Naman-K06/RIS_2.4Ghz/Matlab/Figures/WP_Figure4_RSSI_Heatmap.pdf

Wireless Performance Comparison

No RIS | 2x2 RIS | 5x5 RIS | 9x9 RIS | 16x16 RIS

Valu

e (Units v

ary)

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
Avg RSSI (Relative)
Avg SNR (dB)
