Naman-K06/RIS_2.4Ghz/Matlab/Figures/RIS_Array.png

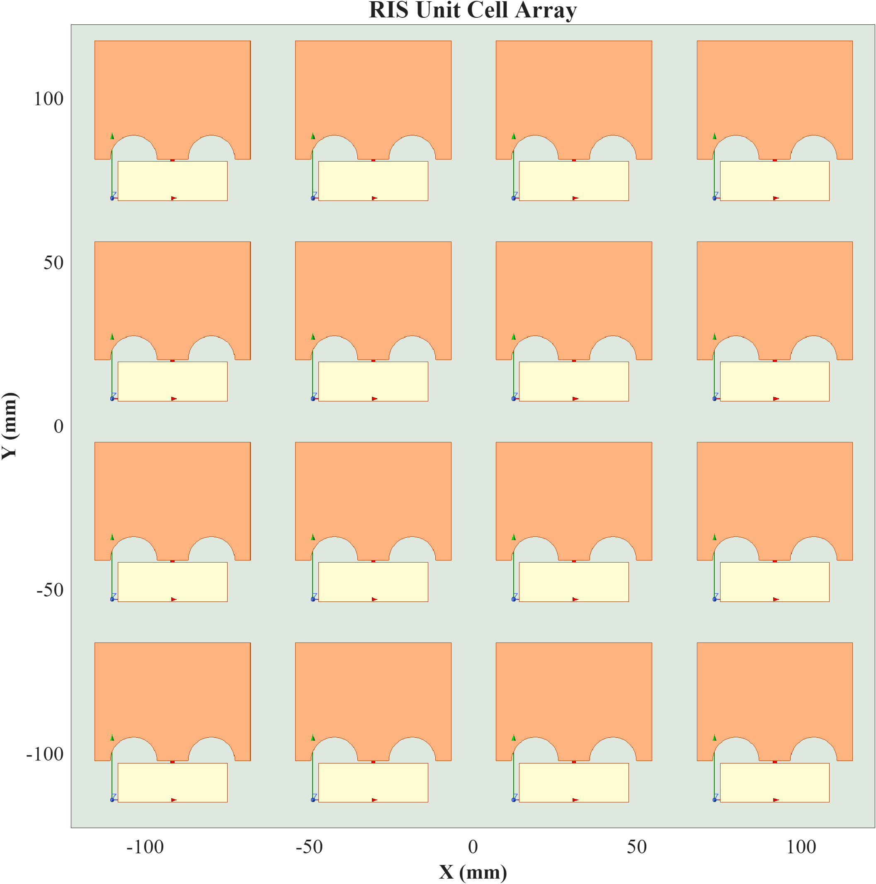
Matlab/Figures/RIS_Array.png
