Naman-K06/RIS_2.4Ghz/Matlab/Figures/SC_Figure1_RSSI.png

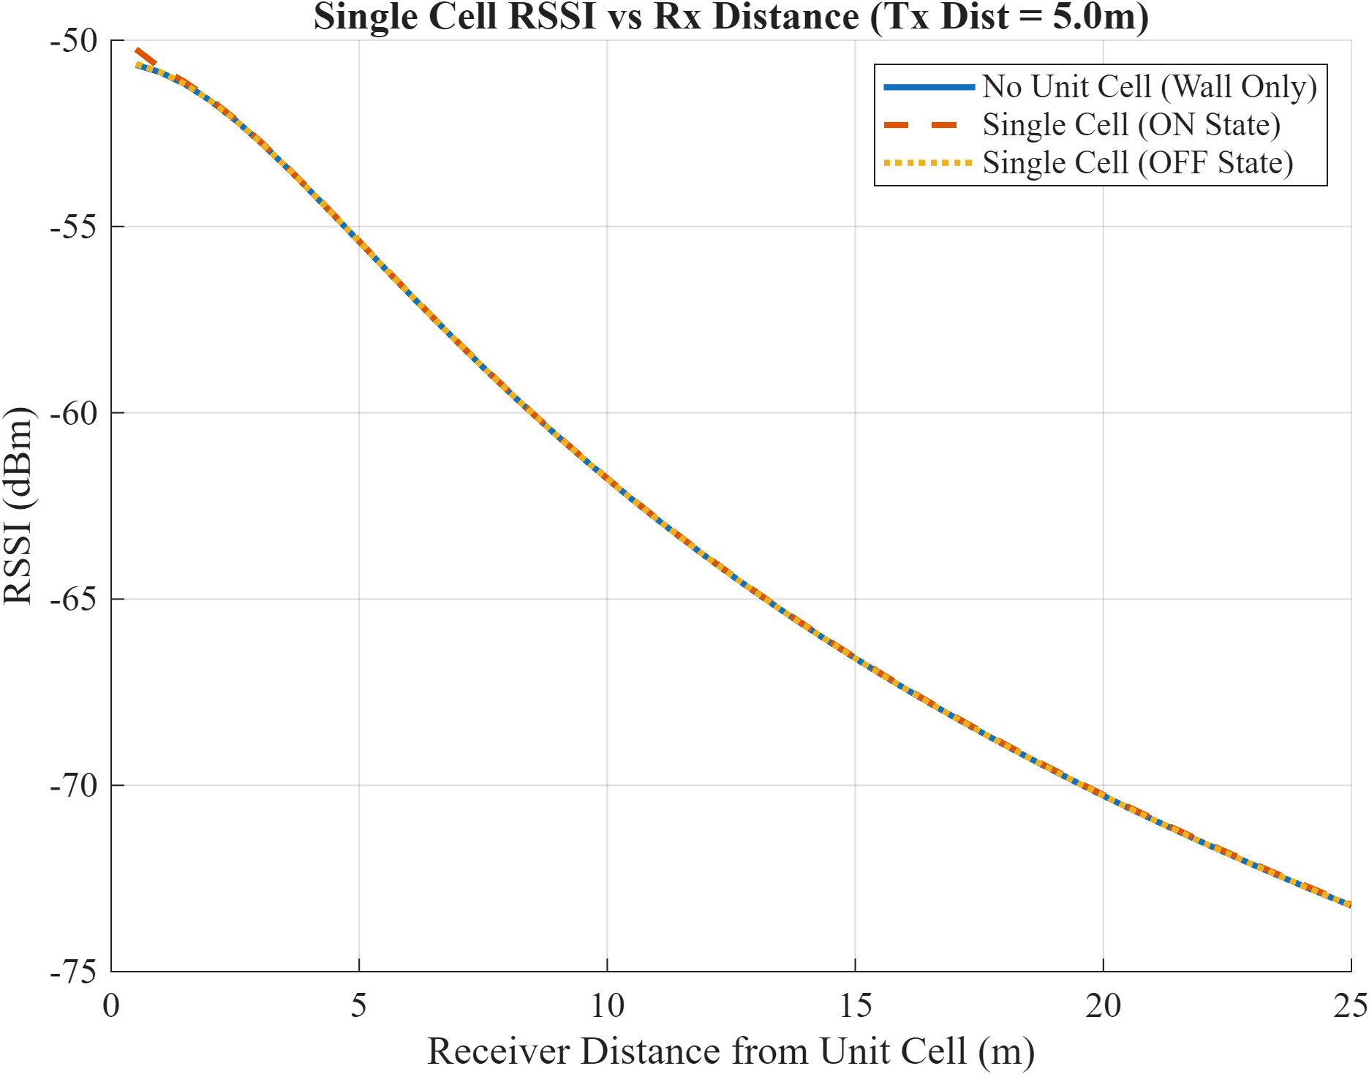
Matlab/Figures/SC_Figure1_RSSI.png
