Naman-K06/RIS_2.4Ghz/Matlab/Figures/SC_Figure2_SNR.png

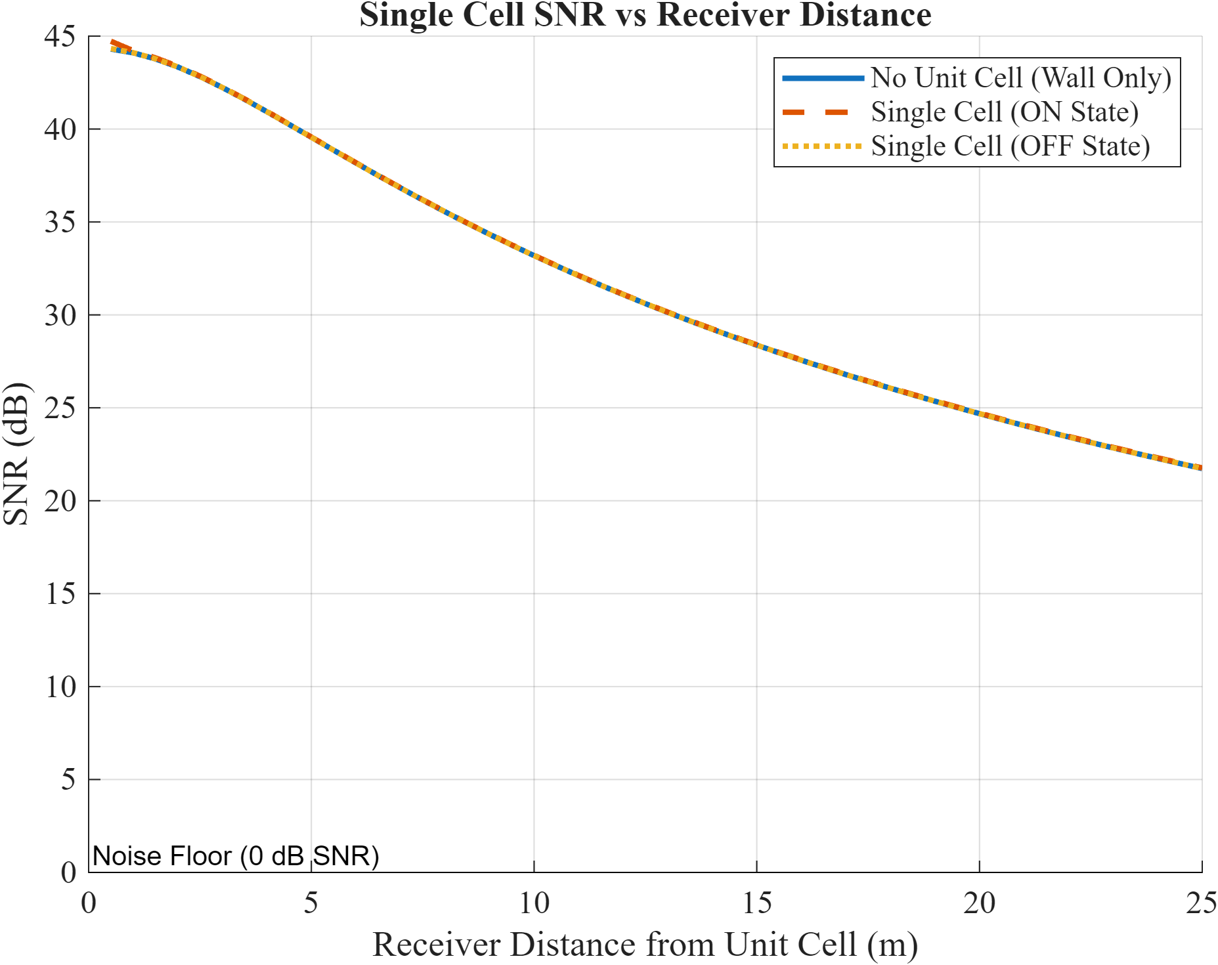
Matlab/Figures/SC_Figure2_SNR.png
