Naman-K06/RIS_2.4Ghz/Matlab/Figures/SC_Figure3_PathLoss.png

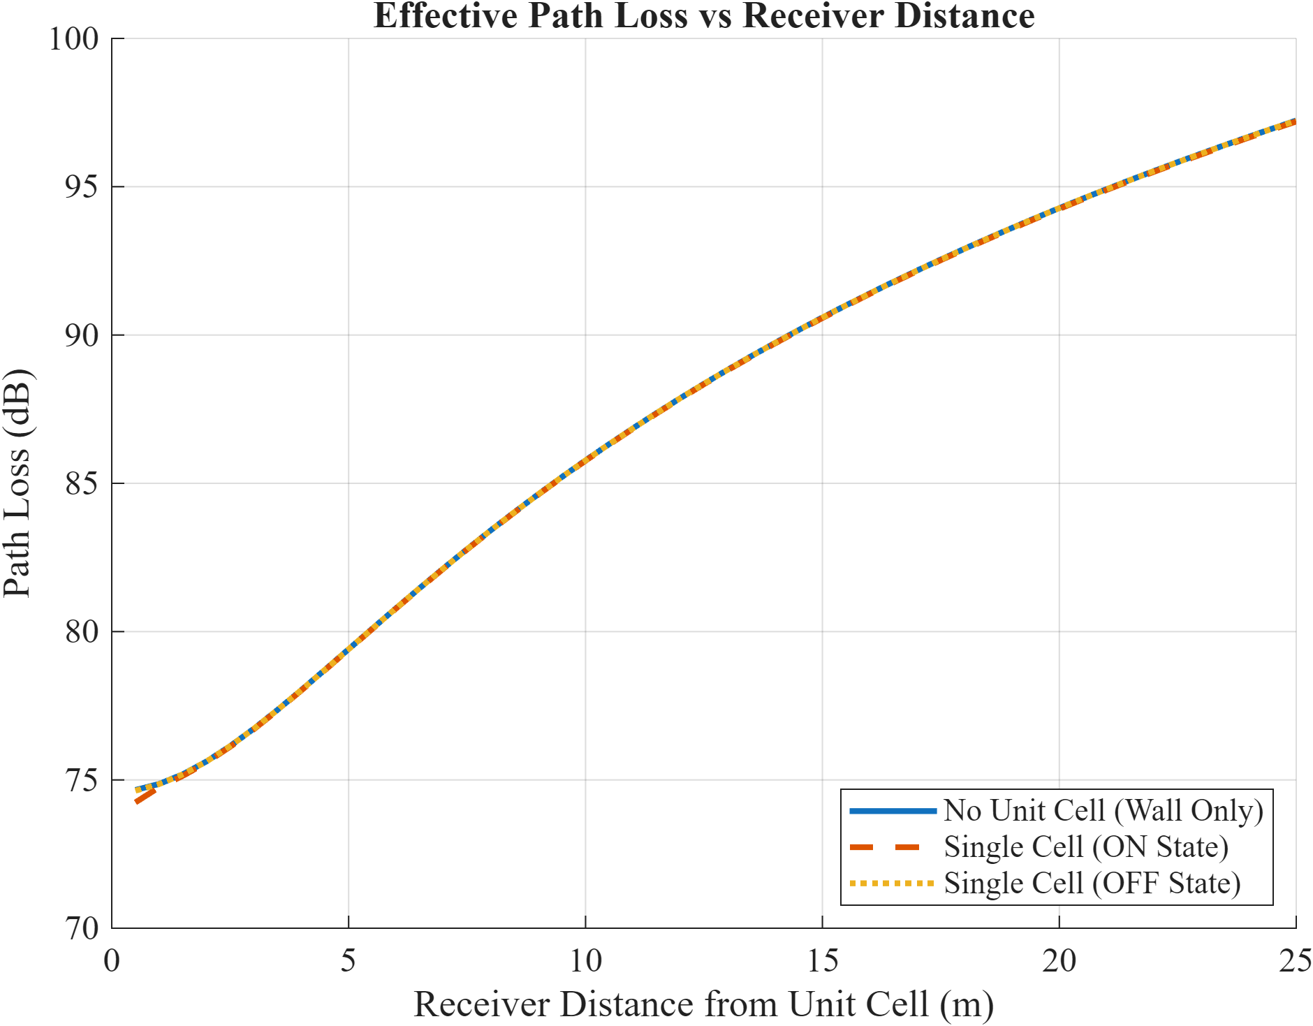
Matlab/Figures/SC_Figure3_PathLoss.png
