Naman-K06/RIS_2.4Ghz/Matlab/Figures/WP_Figure1_RSSI.png

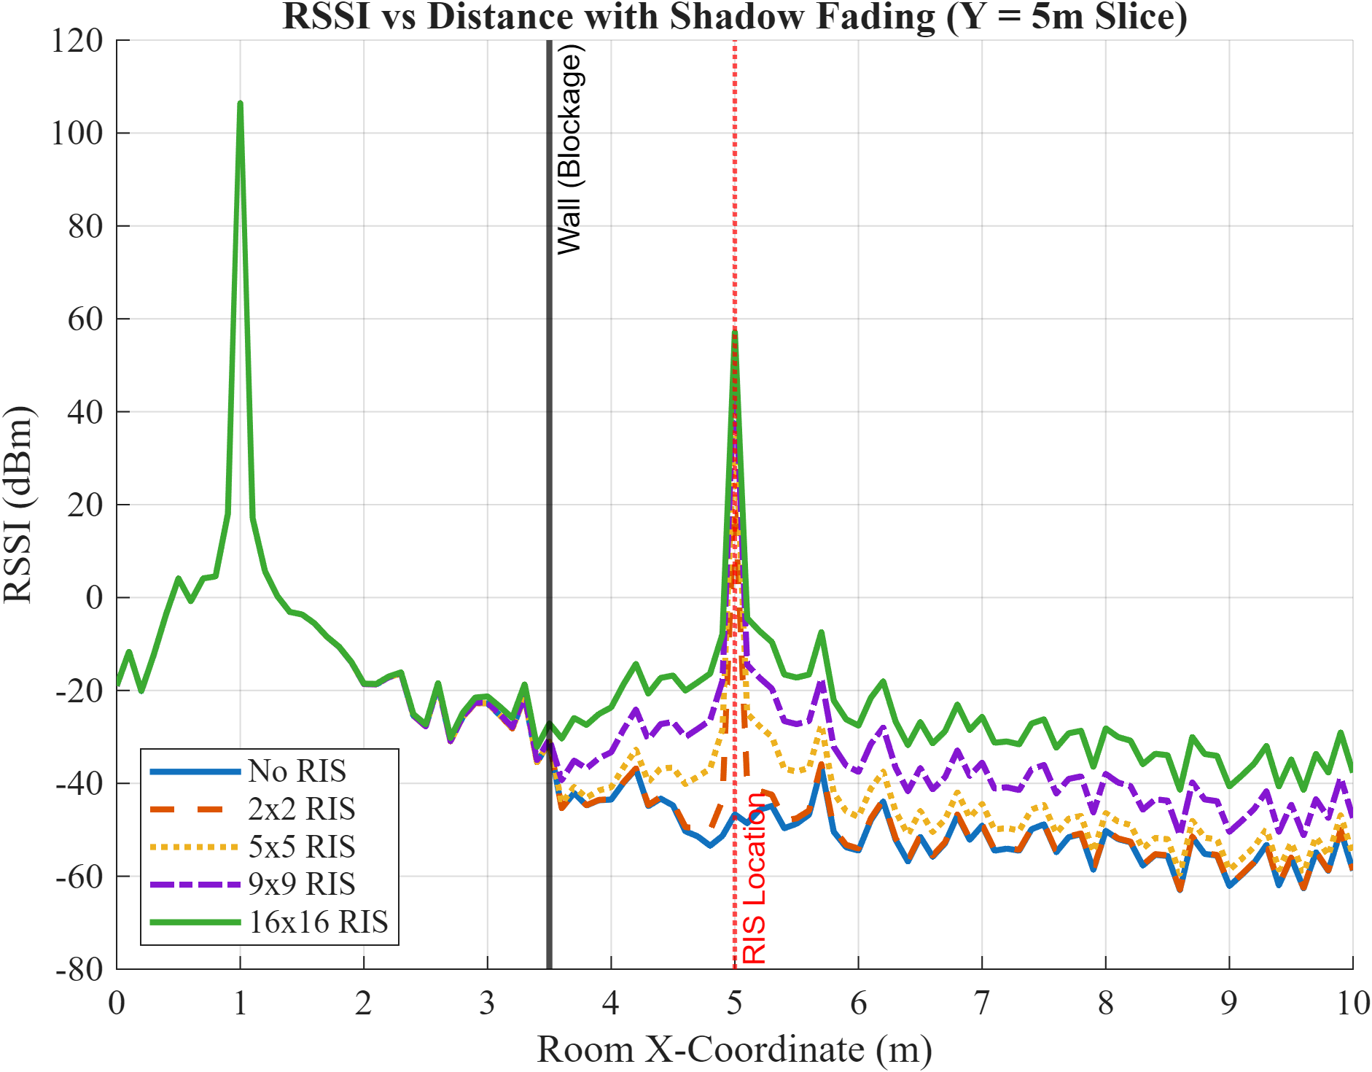
Matlab/Figures/WP_Figure1_RSSI.png
