Naman-K06/RIS_2.4Ghz/Matlab/Figures/WP_Figure2_SNR.png

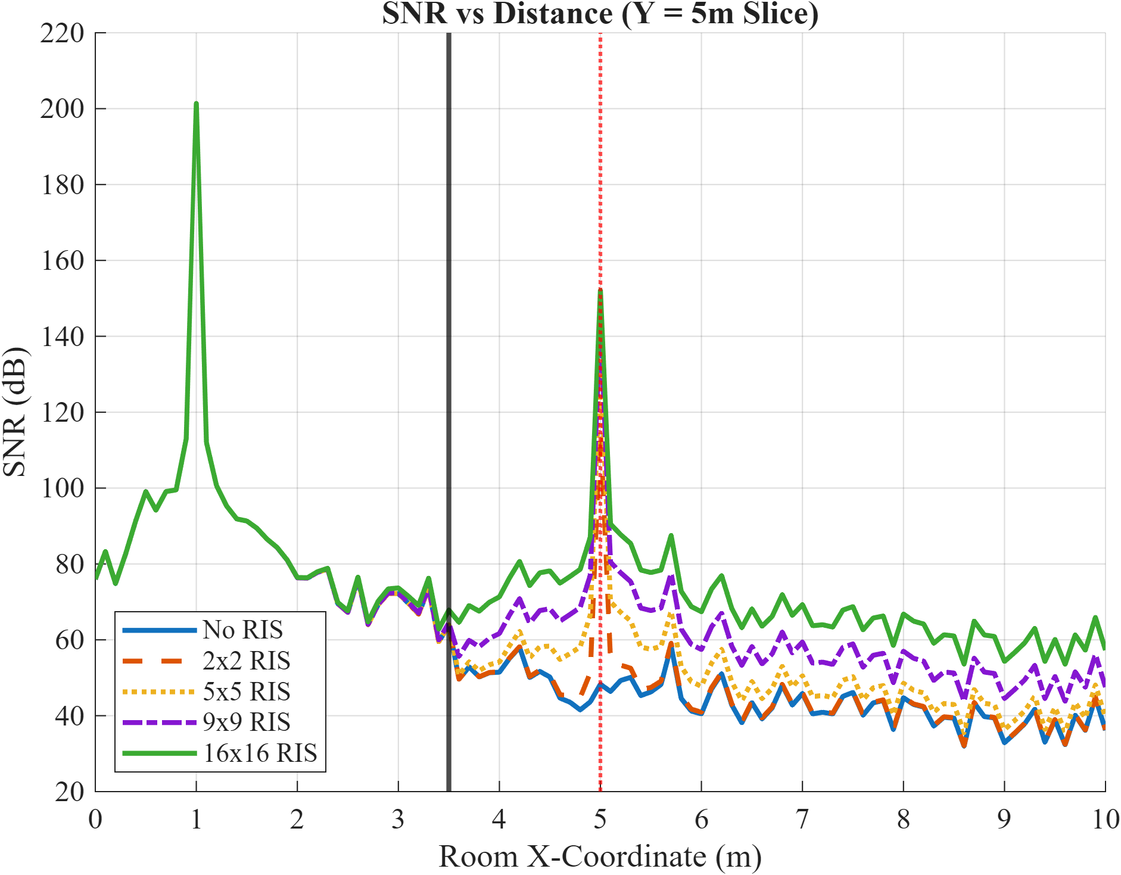
Matlab/Figures/WP_Figure2_SNR.png
