Naman-K06/RIS_2.4Ghz/Matlab/Figures/WP_Figure3_PathLoss.png

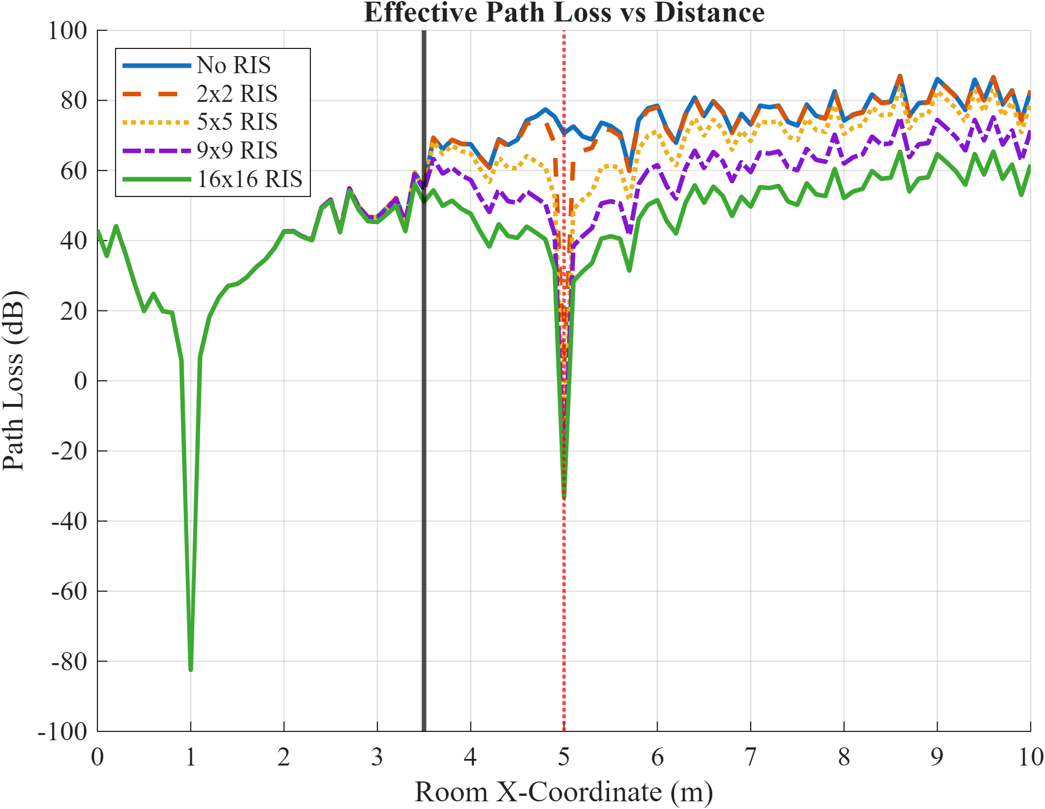
Matlab/Figures/WP_Figure3_PathLoss.png
