Naman-K06/RIS_2.4Ghz/Matlab/Figures/WP_Figure4_RSSI_Heatmap.png

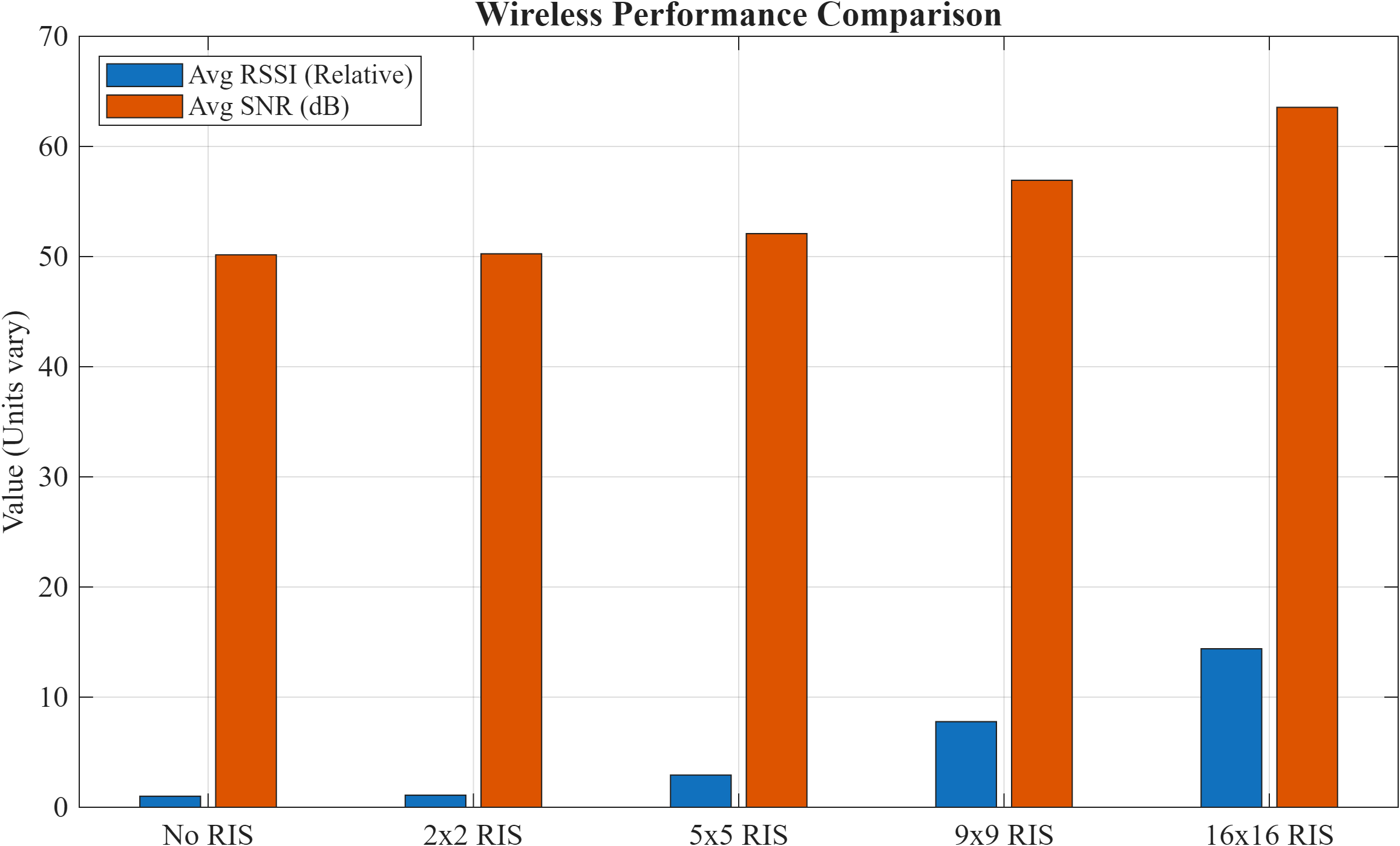
Matlab/Figures/WP_Figure4_RSSI_Heatmap.png
