Naman-K06/RIS_2.4Ghz/Matlab/Unit Cell/UnitCell.png

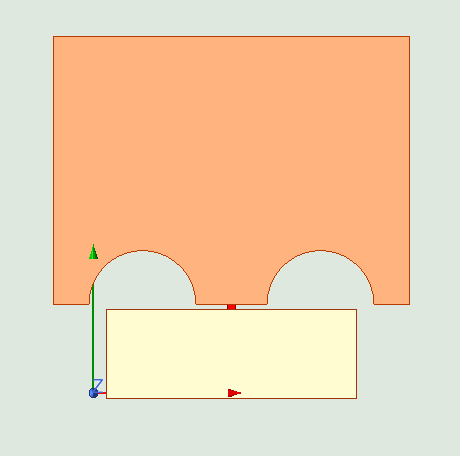
Matlab/Unit Cell/UnitCell.png
