Naman-K06/RIS_2.4Ghz/Matlab/Results/Performance_Table.csv

Configuration | Average_RSSI_dBm | Maximum_RSSI_dBm | Average_SNR_dB | Average_PathLoss_dB | RIS_Gain_dBi
No RIS | -44.8068115417836 | 106.429171015718 | 50.1580756958048 | 68.8068115417836 | 0
2x2 RIS | -44.71292778017 | 106.429171015718 | 50.2519594574183 | 68.71292778017 | 8.21926683868648
5x5 RIS | -42.880865383174 | 106.429171015718 | 52.0840218544144 | 66.8808653831739 | 24.136867185568
9x9 RIS | -38.036544857148 | 106.429171015718 | 56.9283423804404 | 62.036544857148 | 34.3477673897002
16x16 RIS | -31.4138692363174 | 106.429171015718 | 63.5510180012709 | 55.4138692363175 | 44.3428663183642
