Naman-K06/RIS_2.4Ghz/Matlab/Results/SingleCell_Table.csv

Configuration | Average_RSSI_dBm | Maximum_RSSI_dBm | Average_SNR_dB | Cell_Reflection_Gain_dBi
No Unit Cell (Wall Only) | -63.3784717167683 | -50.6612759926142 | 31.58641552082 | 0
Single Cell (ON State) | -63.347731972075 | -50.2411887809816 | 31.6171552655133 | 3.815
Single Cell (OFF State) | -63.376726748319 | -50.6366891254302 | 31.5881604892693 | -8.7108
