Naman-K06/RIS_2.4Ghz/RIS Results/2x2 Array/Screenshot 2026-08-10 184113.png

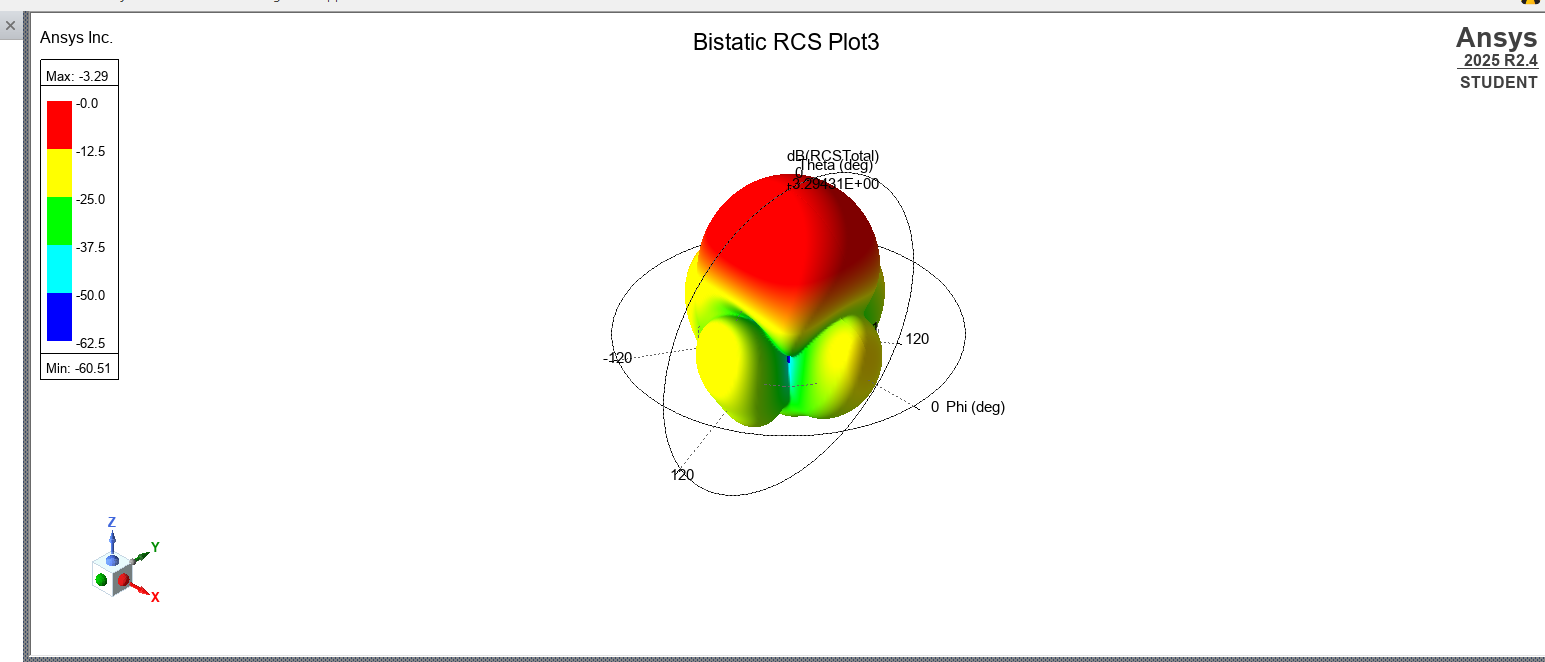
RIS Results/2x2 Array/Screenshot 2026-08-10 184113.png
