Naman-K06/RIS_2.4Ghz/RIS Results/4x4 Array/Screenshot 2026-08-18 163440.png

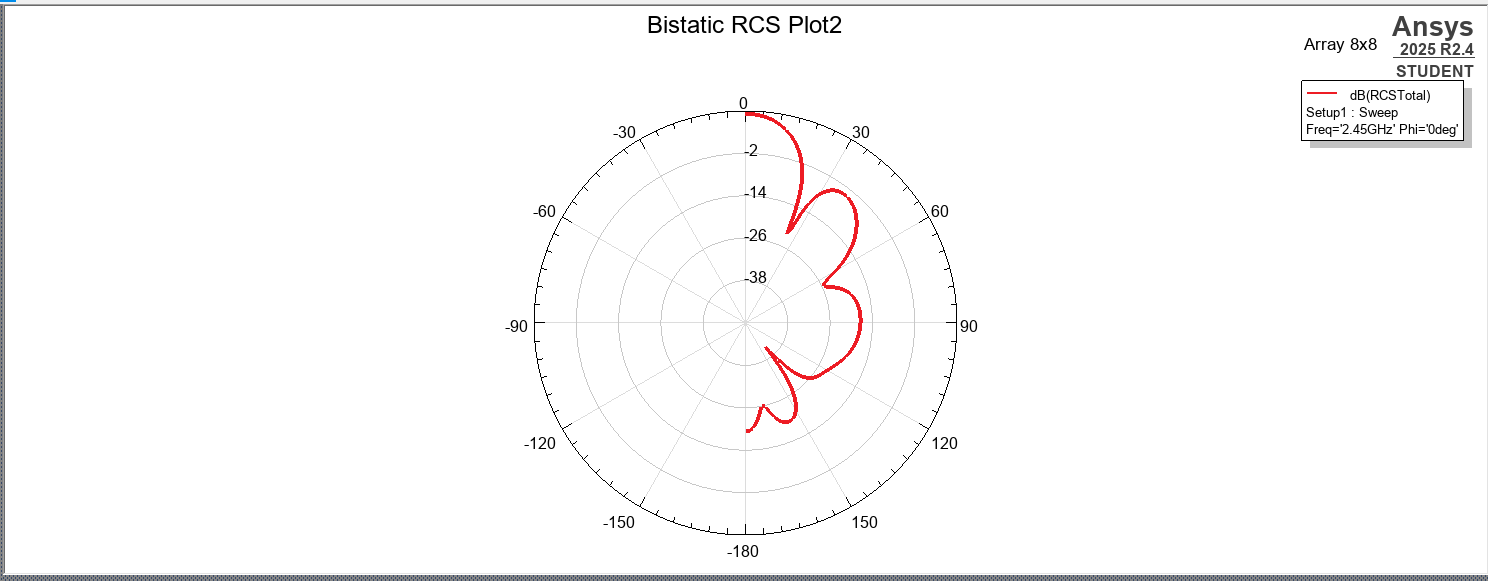
RIS Results/4x4 Array/Screenshot 2026-08-18 163440.png
