Naman-K06/RIS_2.4Ghz/RIS Results/Bias Control Circuit/Screenshot 2026-08-30 230548.png

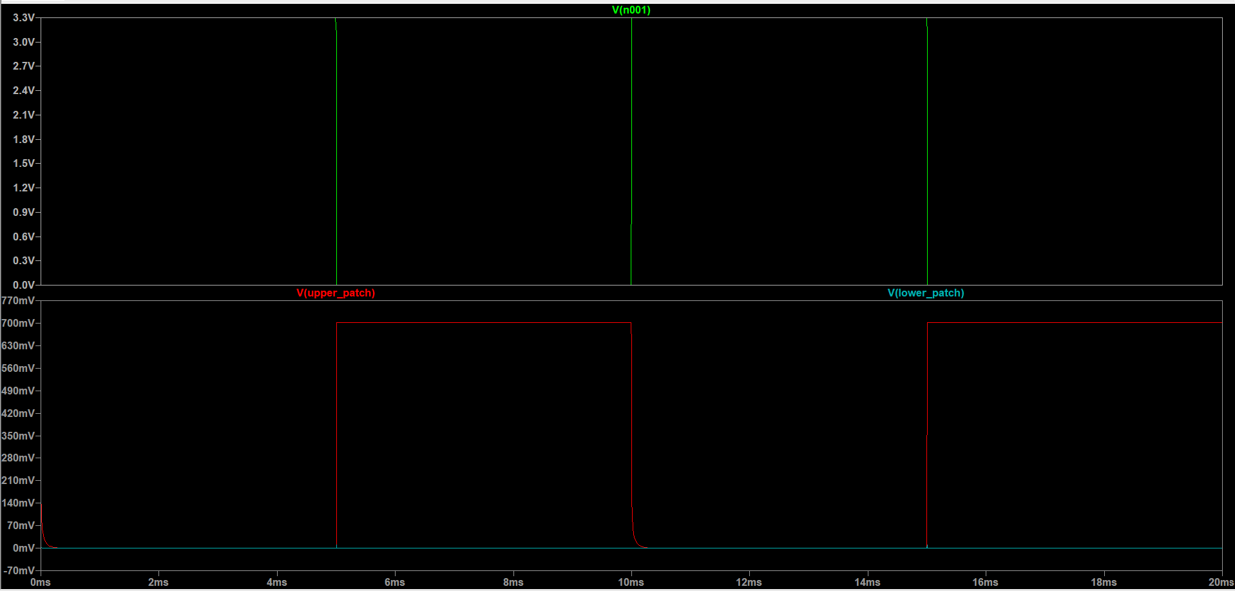
RIS Results/Bias Control Circuit/Screenshot 2026-08-30 230548.png
