Naman-K06/RIS_2.4Ghz/RIS Results/Bias Control Circuit/Screenshot 2026-09-07 162614.png

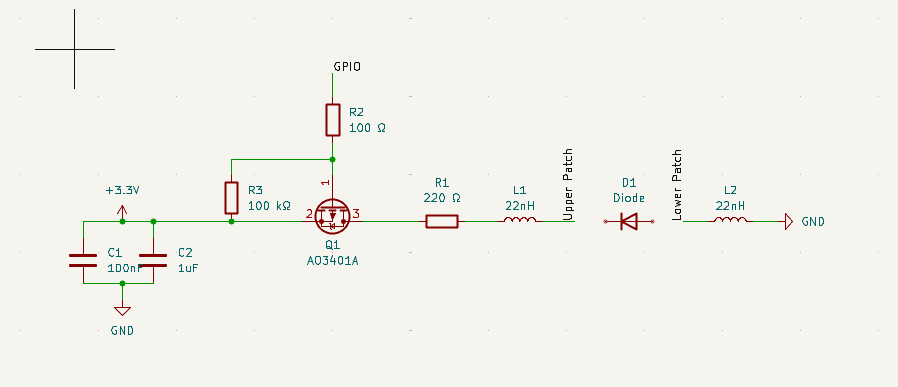
RIS Results/Bias Control Circuit/Screenshot 2026-09-07 162614.png
