Naman-K06/RIS_2.4Ghz/RIS Results/Unit Cell/Bias Lines/Screenshot 2026-08-21 224558.png

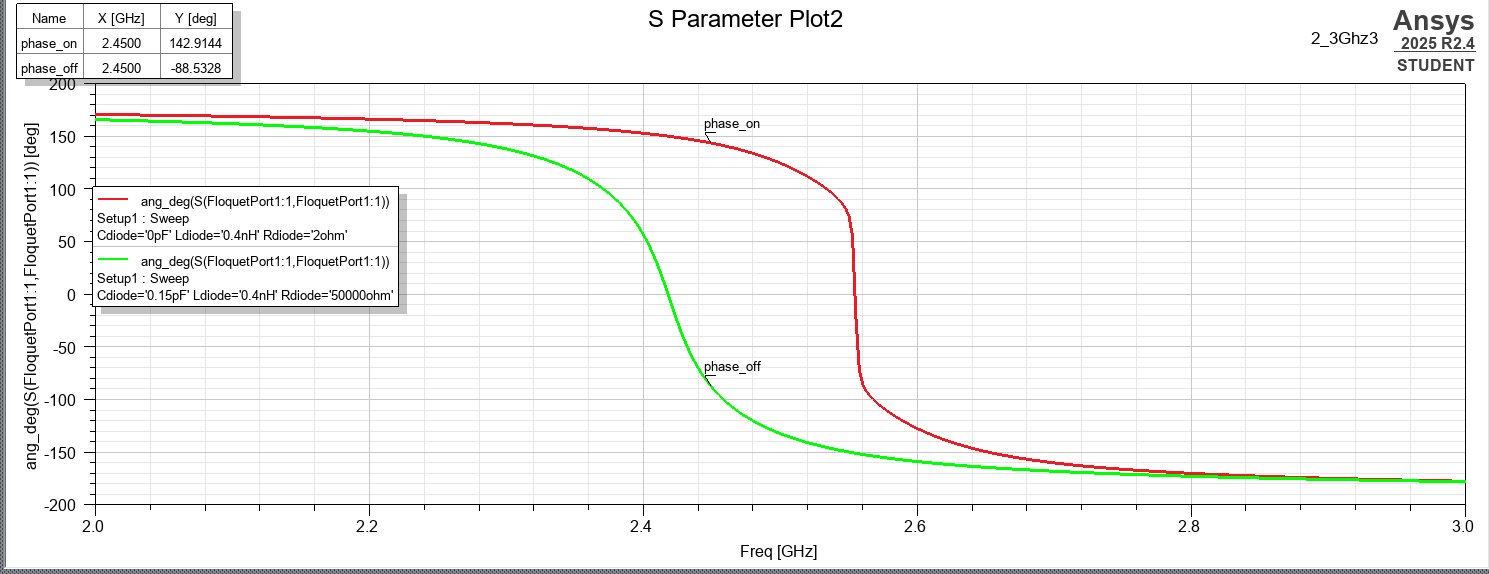
RIS Results/Unit Cell/Bias Lines/Screenshot 2026-08-21 224558.png
