Naman-K06/RIS_2.4Ghz/RIS Results/Unit Cell/Mag J off.png

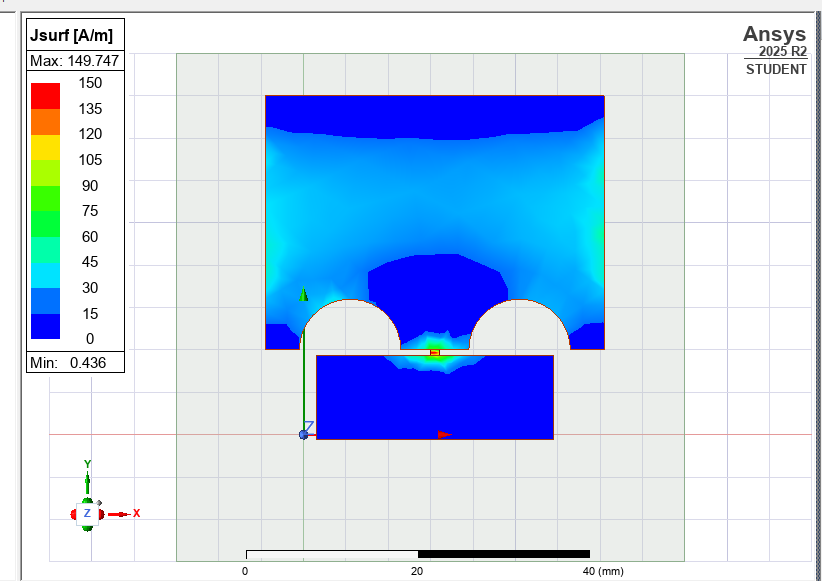
RIS Results/Unit Cell/Mag J off.png
