Naman-K06/RIS_2.4Ghz/RIS Results/Unit Cell/Phase Diffrence.png

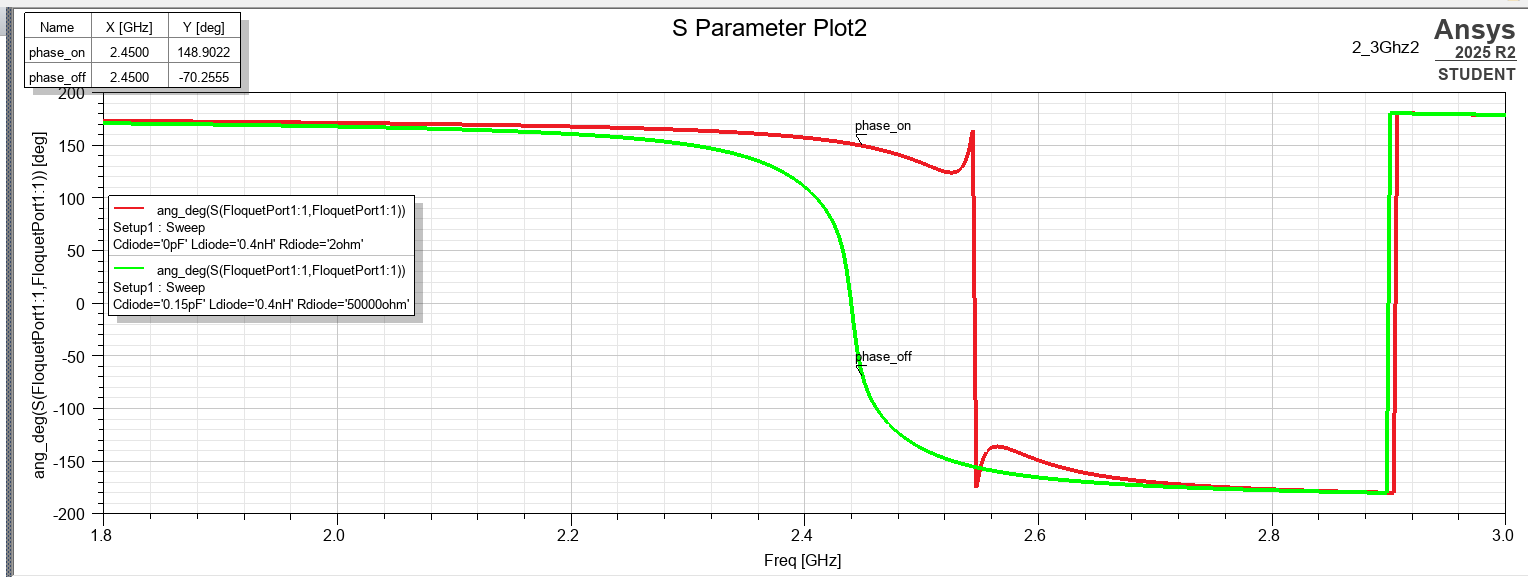
RIS Results/Unit Cell/Phase Diffrence.png
