Naman-K06/RIS_2.4Ghz/RIS Results/Unit Cell/Screenshot 2026-07-09 210532.png

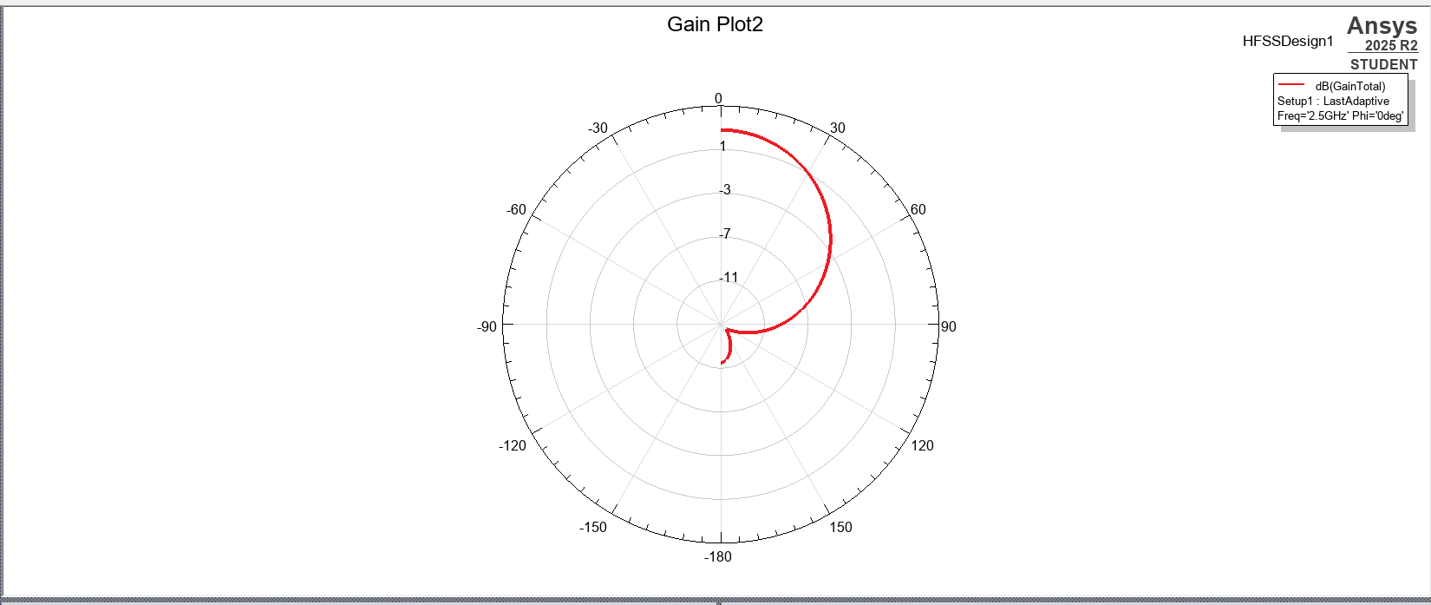
RIS Results/Unit Cell/Screenshot 2026-07-09 210532.png
