Naman-K06/RIS_2.4Ghz/RIS Results/Unit Cell/Unit cell Close.png

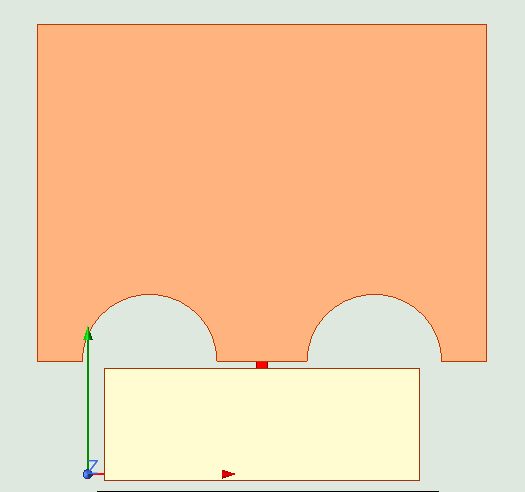
RIS Results/Unit Cell/Unit cell Close.png
