Naman-K06/RIS_2.4Ghz/RIS Results/Unit Cell/Unit Cell Top.png

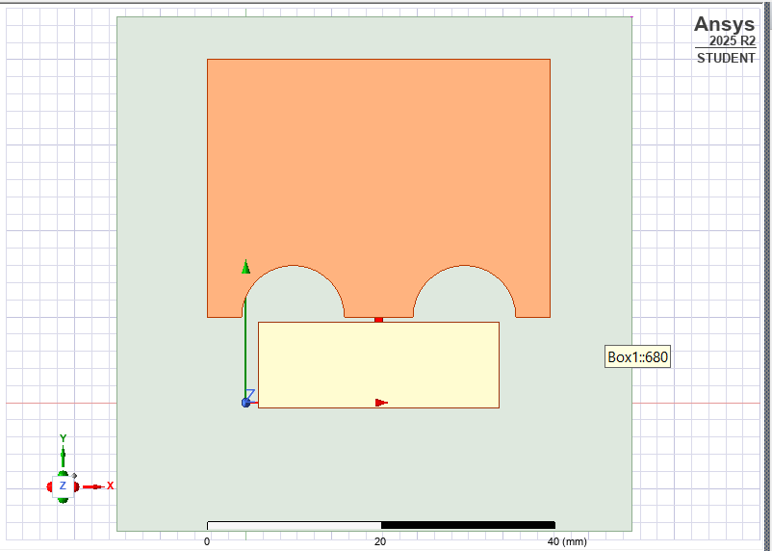
RIS Results/Unit Cell/Unit Cell Top.png
