Naman-K06/RIS_2.4Ghz/RIS Results/Unit Cell/Vector 2.45.png

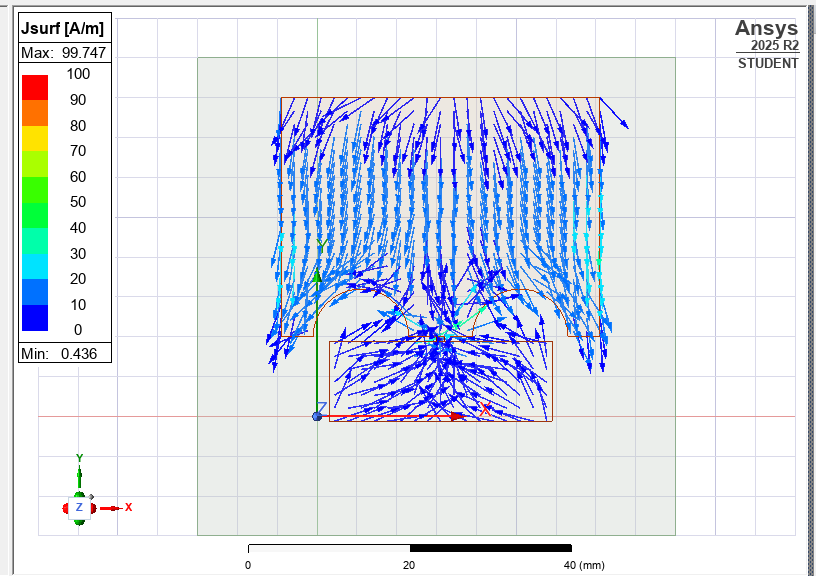
RIS Results/Unit Cell/Vector 2.45.png
