Naman-K06/RIS_2.4Ghz/Matlab/Figures/SC_Figure1_RSSI.pdf

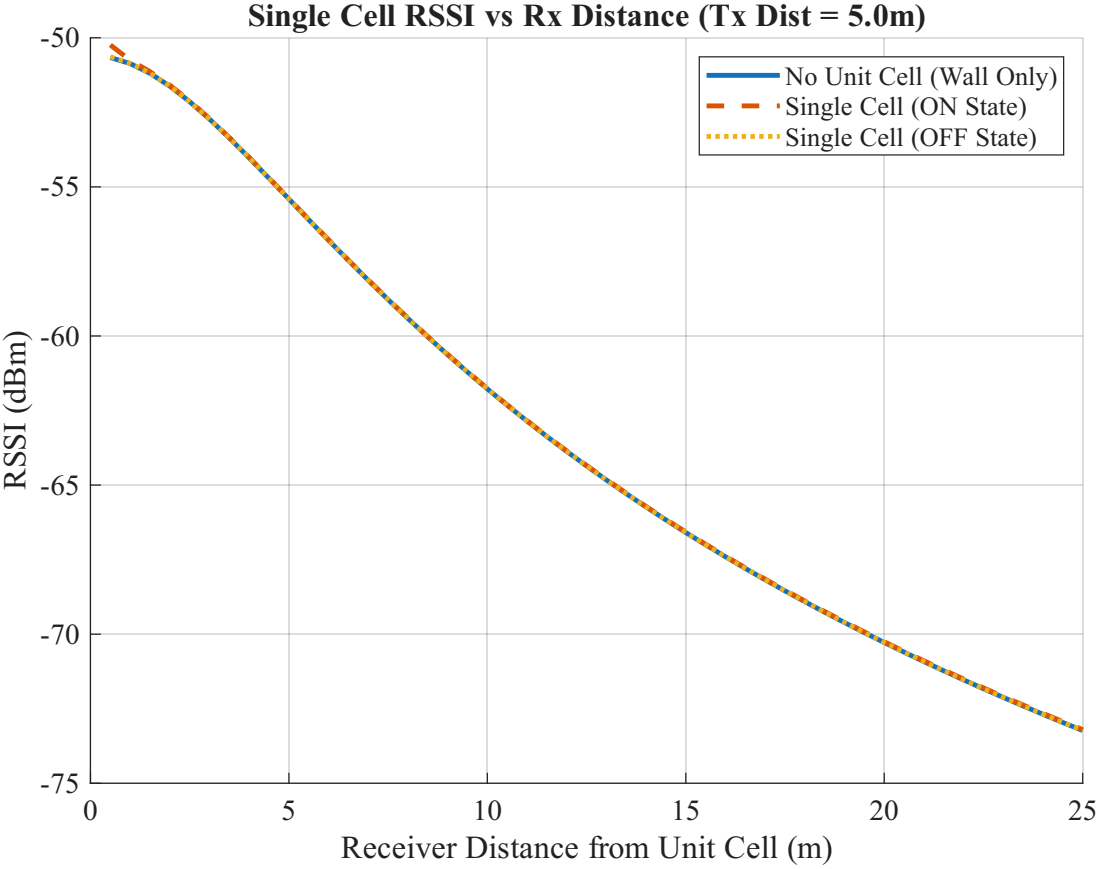
[picture p96: page 1]

Single Cell RSSI vs Rx Distance (Tx Dist = 5.0m)

No Unit Cell (Wall Only)
Single Cell (ON State)
Single Cell (OFF State)

Receiver Distance from Unit Cell (m)
