Naman-K06/RIS_2.4Ghz/Matlab/Figures/SC_Figure2_SNR.pdf

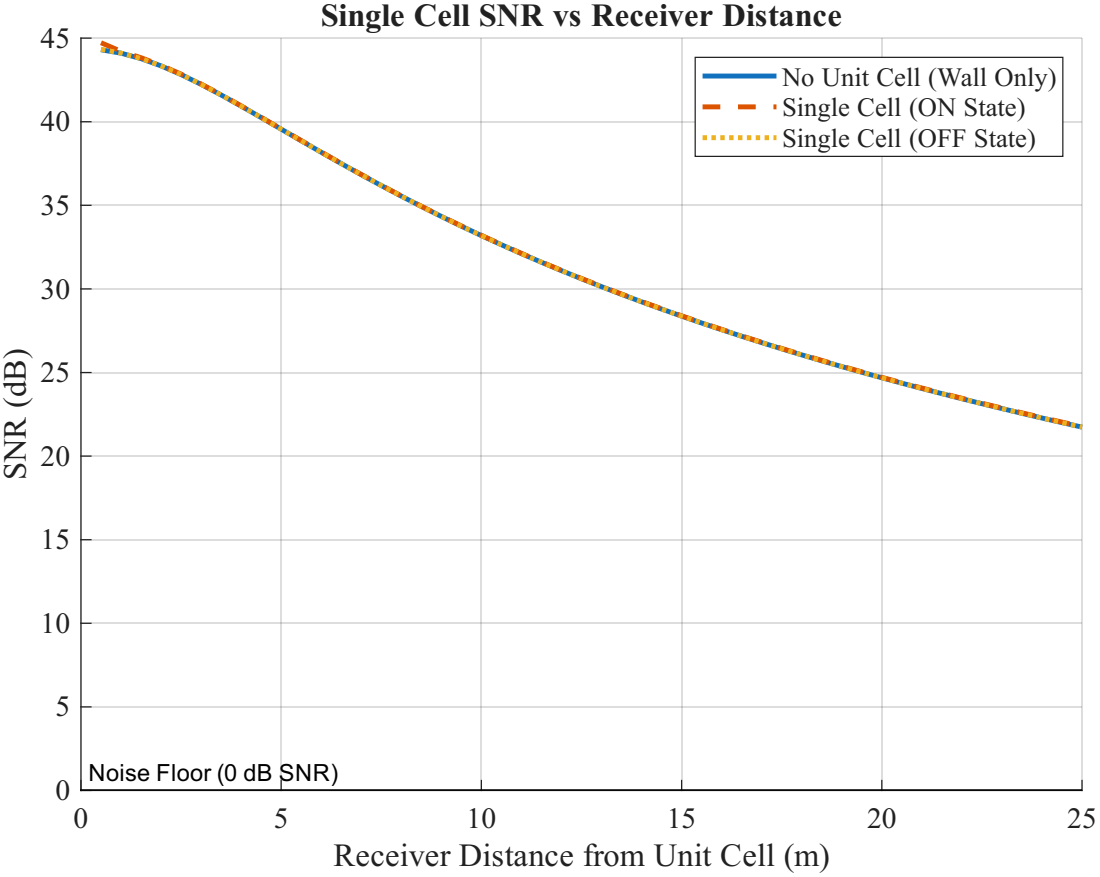
[picture p97: page 1]

Single Cell SNR vs Receiver Distance

No Unit Cell (Wall Only) Single Cell (ON State)

Single Cell (OFF State)

Noise Floor (0 dB SNR)

Receiver Distance from Unit Cell (m)
