Naman-K06/RIS_2.4Ghz/Matlab/Figures/WP_Figure1_RSSI.pdf

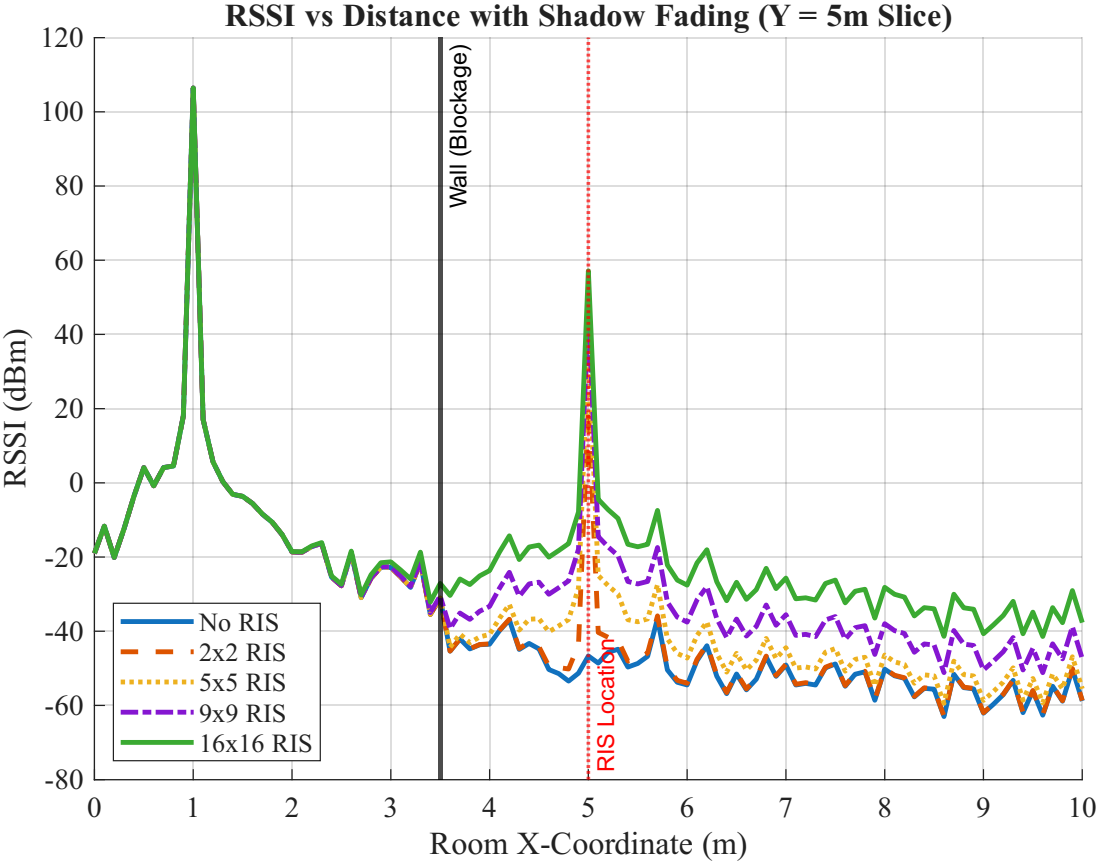
[picture p98: page 1]
Room X-Coordinate (m); Wall (Blockage); RIS Location

RSSI vs Distance with Shadow Fading (Y = 5m Slice)

No RIS
2x2 RIS 5x5 RIS

9x9 RIS 16x16 RIS
