Naman-K06/RIS_2.4Ghz/Matlab/Figures/WP_Figure2_SNR.pdf

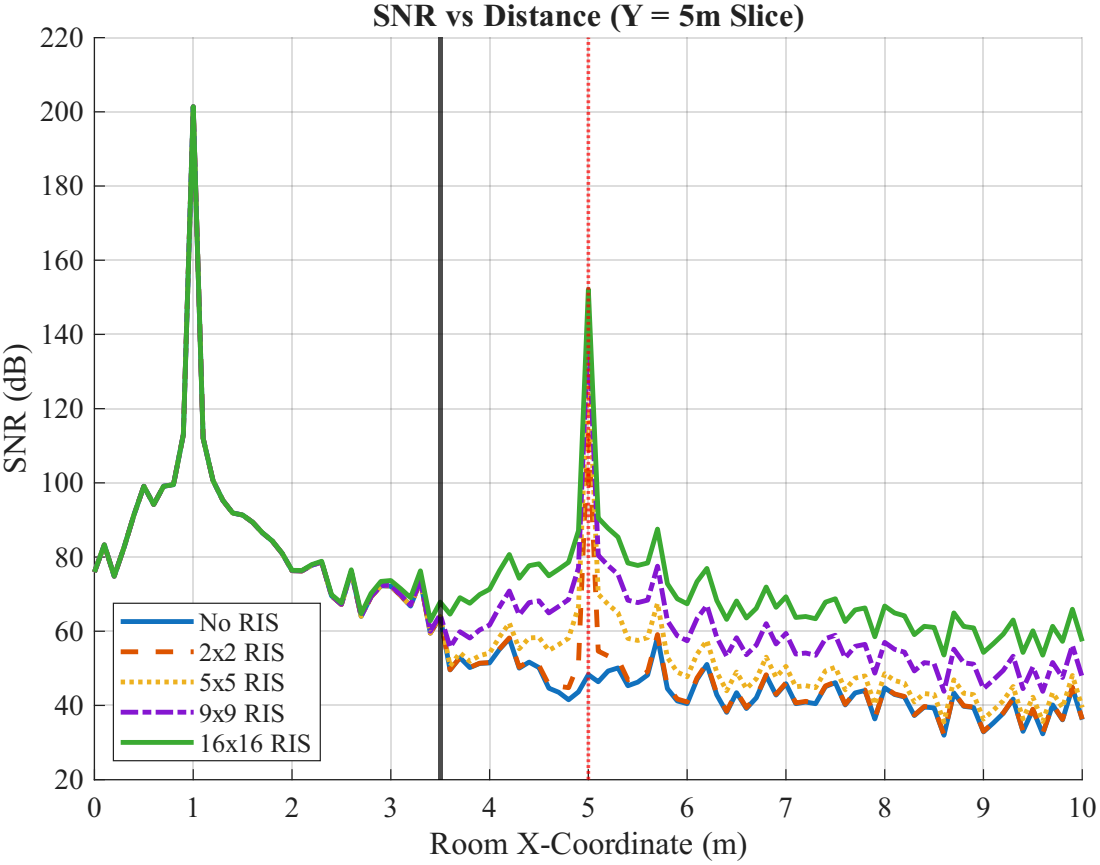
[picture p99: page 1]
Room X-Coordinate (m)

SNR vs Distance (Y = 5m Slice)

No RIS
2x2 RIS 5x5 RIS

9x9 RIS 16x16 RIS
