Naman-K06/RIS_2.4Ghz/Matlab/Figures/WP_Figure3_PathLoss.pdf

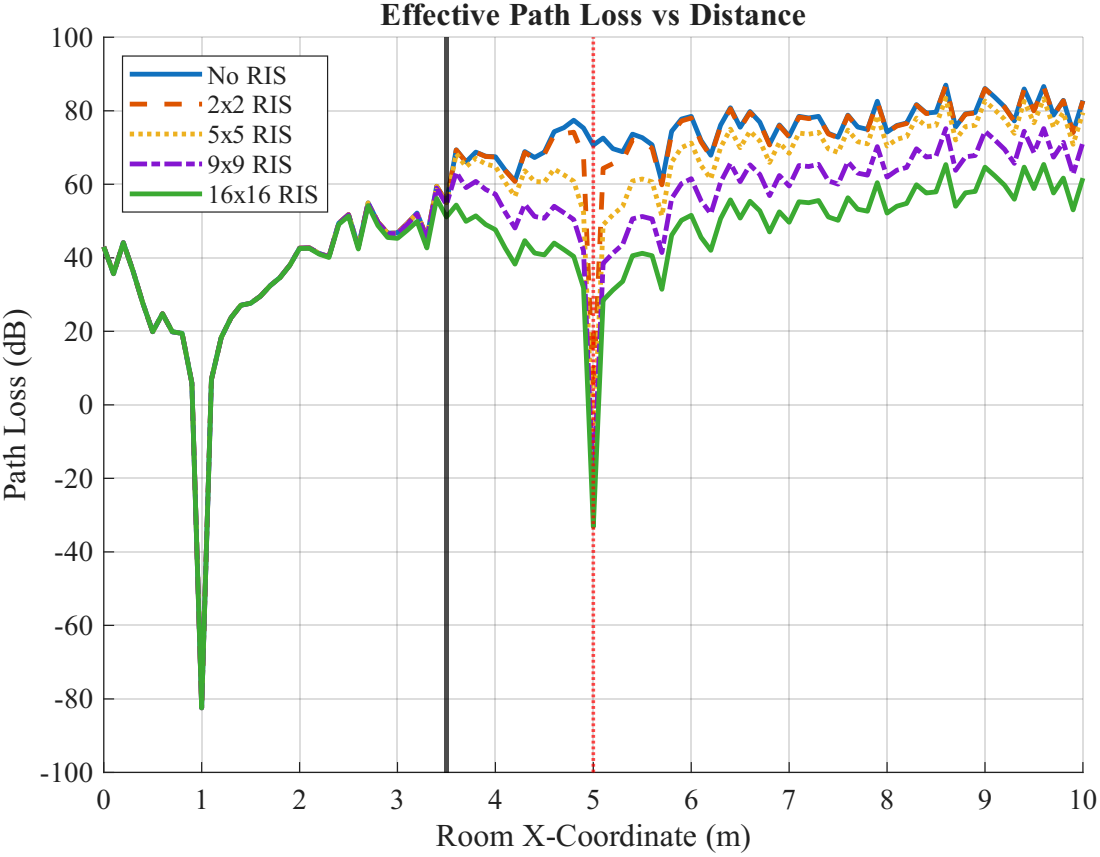
[picture p100: page 1]
Room X-Coordinate (m); ath; oss (d

Effective Path Loss vs Distance

No RIS 2x2 RIS

5x5 RIS 9x9 RIS

16x16 RIS
