Naman-K06/RIS_2.4Ghz/RIS 4x4/RIS.kicad_pcb

## KiCad design RIS 4x4/RIS.kicad_pcb (2026-10-09)

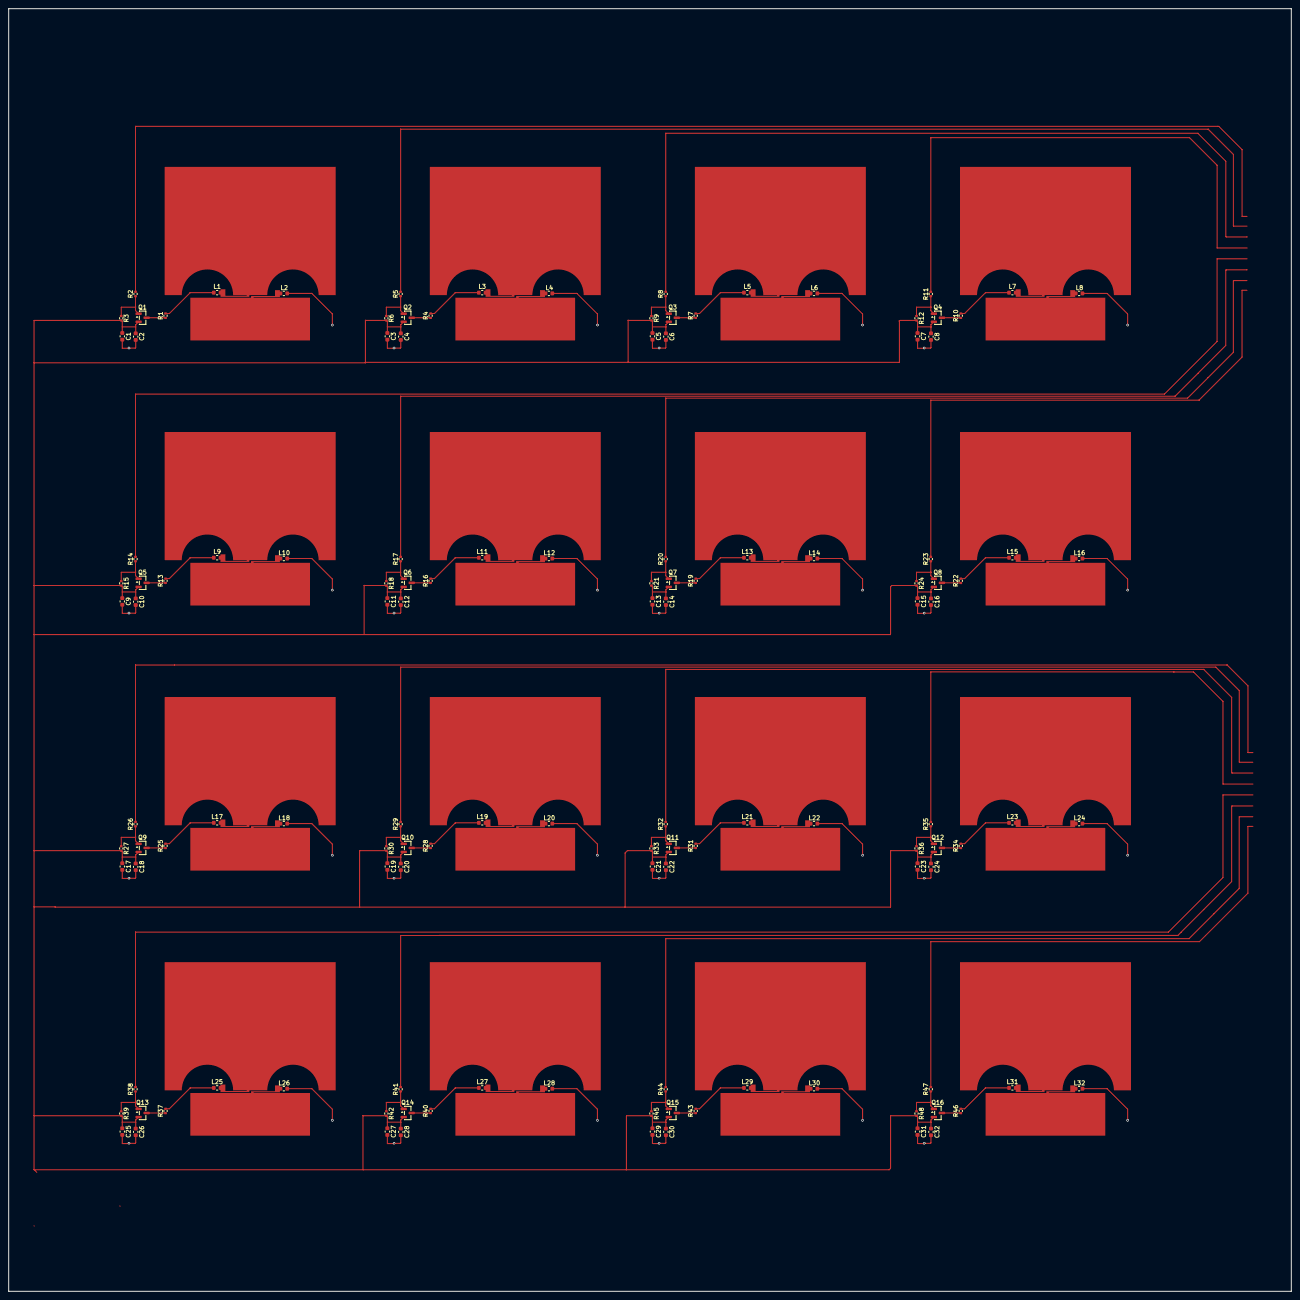
[picture p101: board RIS 4x4/RIS.kicad_pcb from above]

Board: 2 copper layers, 300.0 x 300.0 mm, 128 parts (0 on the bottom side), 6 nets.

Parts:
C1, C3, C5, C7, C9, C11, C13, C15, C17, C19, C21, C23, C25, C27, C29, C31: 100nF; C_0603_1608Metric
C2, C4, C6, C8, C10, C12, C14, C16, C18, C20, C22, C24, C26, C28, C30, C32: 1uF; C_0603_1608Metric
L1, L2, L3, L4, L5, L6, L7, L8, L9, L10, L11, L12, L13, L14, L15, L16, L17, L18, L19, L20, L21, L22, L23, L24, L25, L26, L27, L28, L29, L30, L31, L32: 22nH; L_0603_1608Metric
Q1, Q2, Q3, Q4, Q5, Q6, Q7, Q8, Q9, Q10, Q11, Q12, Q13, Q14, Q15, Q16: AO3401A; SOT-23
R1, R4, R7, R10, R13, R16, R19, R22, R25, R28, R31, R34, R37, R40, R43, R46: 220 Ω; R_0402_1005Metric
R2, R5, R8, R11, R14, R17, R20, R23, R26, R29, R32, R35, R38, R41, R44, R47: 100 Ω; R_0402_1005Metric
R3, R6, R9, R12, R15, R18, R21, R24, R27, R30, R33, R36, R39, R42, R45, R48: 100 kΩ; R_0402_1005Metric

Connections:
+3.3V: C1.1, C2.1, C3.1, C4.1, C5.1, C6.1, C7.1, C8.1, C9.1, C10.1, C11.1, C12.1, C13.1, C14.1, C15.1, C16.1, C17.1, C18.1, C19.1, C20.1, C21.1, C22.1, C23.1, C24.1, C25.1, C26.1, C27.1, C28.1, C29.1, C30.1, C31.1, C32.1, Q1.2 (S), Q2.2 (S), Q3.2 (S), Q4.2 (S), Q5.2 (S), Q6.2 (S), Q7.2 (S), Q8.2 (S), Q9.2 (S), Q10.2 (S), Q11.2 (S), Q12.2 (S), Q13.2 (S), Q14.2 (S), Q15.2 (S), Q16.2 (S), R3.2, R6.2, R9.2, R12.2, R15.2, R18.2, R21.2, R24.2, R27.2, R30.2, R33.2, R36.2, R39.2, R42.2, R45.2, R48.2
/GPIO: R2.2, R5.2, R8.2, R11.2, R14.2, R17.2, R20.2, R23.2, R26.2, R29.2, R32.2, R35.2, R38.2, R41.2, R44.2, R47.2
GND: C1.2, C2.2, C3.2, C4.2, C5.2, C6.2, C7.2, C8.2, C9.2, C10.2, C11.2, C12.2, C13.2, C14.2, C15.2, C16.2, C17.2, C18.2, C19.2, C20.2, C21.2, C22.2, C23.2, C24.2, C25.2, C26.2, C27.2, C28.2, C29.2, C30.2, C31.2, C32.2, L2.2 (2_2), L4.2 (2_2), L6.2 (2_2), L8.2 (2_2), L10.2 (2_2), L12.2 (2_2), L14.2 (2_2), L16.2 (2_2), L18.2 (2_2), L20.2 (2_2), L22.2 (2_2), L24.2 (2_2), L26.2 (2_2), L28.2 (2_2), L30.2 (2_2), L32.2 (2_2)
unnamed: L1.1 (1_1), L3.1 (1_1), L5.1 (1_1), L7.1 (1_1), L9.1 (1_1), L11.1 (1_1), L13.1 (1_1), L15.1 (1_1), L17.1 (1_1), L19.1 (1_1), L21.1 (1_1), L23.1 (1_1), L25.1 (1_1), L27.1 (1_1), L29.1 (1_1), L31.1 (1_1), R1.2, R4.2, R7.2, R10.2, R13.2, R16.2, R19.2, R22.2, R25.2, R28.2, R31.2, R34.2, R37.2, R40.2, R43.2, R46.2
unnamed: Q1.3 (D), Q2.3 (D), Q3.3 (D), Q4.3 (D), Q5.3 (D), Q6.3 (D), Q7.3 (D), Q8.3 (D), Q9.3 (D), Q10.3 (D), Q11.3 (D), Q12.3 (D), Q13.3 (D), Q14.3 (D), Q15.3 (D), Q16.3 (D), R1.1, R4.1, R7.1, R10.1, R13.1, R16.1, R19.1, R22.1, R25.1, R28.1, R31.1, R34.1, R37.1, R40.1, R43.1, R46.1
unnamed: Q1.1 (G), Q2.1 (G), Q3.1 (G), Q4.1 (G), Q5.1 (G), Q6.1 (G), Q7.1 (G), Q8.1 (G), Q9.1 (G), Q10.1 (G), Q11.1 (G), Q12.1 (G), Q13.1 (G), Q14.1 (G), Q15.1 (G), Q16.1 (G), R2.1, R3.1, R5.1, R6.1, R8.1, R9.1, R11.1, R12.1, R14.1, R15.1, R17.1, R18.1, R20.1, R21.1, R23.1, R24.1, R26.1, R27.1, R29.1, R30.1, R32.1, R33.1, R35.1, R36.1, R38.1, R39.1, R41.1, R42.1, R44.1, R45.1, R47.1, R48.1
