Naman-K06/RIS_2.4Ghz/RIS/RIS.kicad_pcb

## KiCad design RIS/RIS.kicad_pcb (2026-10-09)

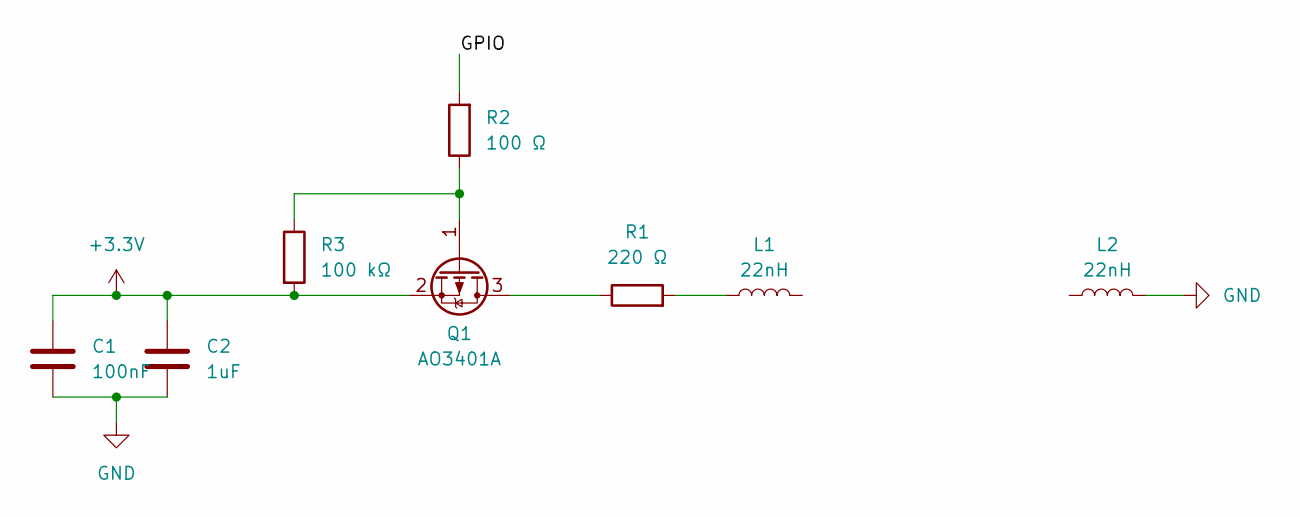
[picture p102: schematic RIS.kicad_sch]

Parts:
C1: 100nF; C_0603_1608Metric
C2: 1uF; C_0603_1608Metric
L1, L2: 22nH; L_0603_1608Metric
Q1: AO3401A; SOT-23
R1: 220 Ω; R_0402_1005Metric
R2: 100 Ω; R_0402_1005Metric
R3: 100 kΩ; R_0402_1005Metric

Connections:
+3.3V: C1.1, C2.1, Q1.2 (S), R3.2
/GPIO: R2.2
GND: C1.2, C2.2, L2.2 (2_2)
unnamed: L1.1 (1_1), R1.2
unnamed: Q1.3 (D), R1.1
unnamed: Q1.1 (G), R2.1, R3.1

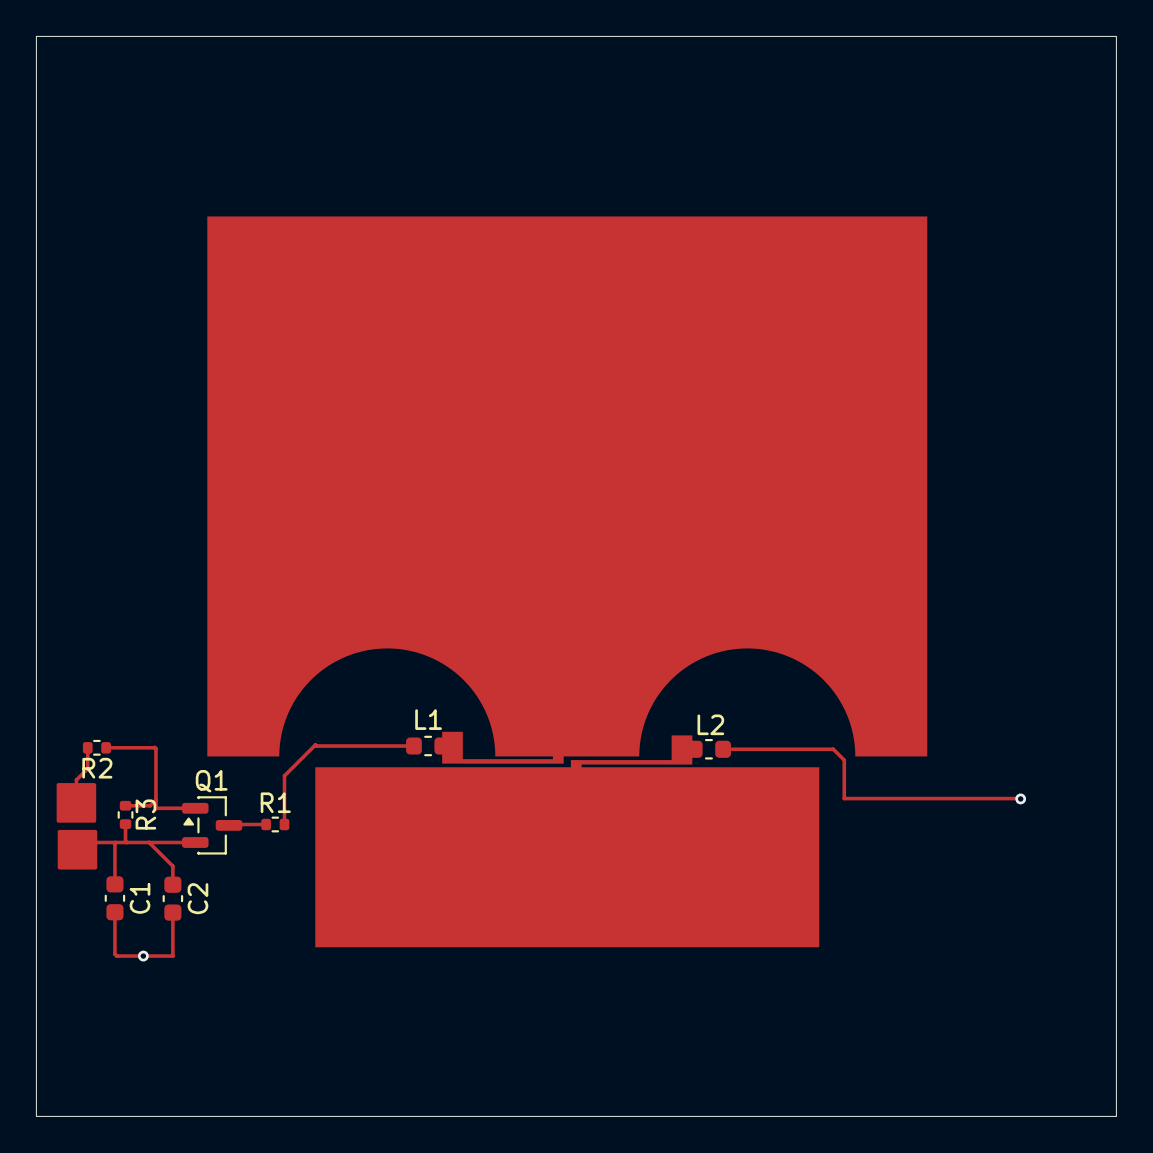
[picture p103: board RIS/RIS.kicad_pcb from above]

Board: 2 copper layers, 60.0 x 60.0 mm, 8 parts (0 on the bottom side), 5 nets.
